HMS-RIC/DattaLab-HumidityChamber/Humidity-Chamber-v1-BOM.xlsx

 |  | Datta Lab Humidity Chamber Controller: Part List
Item | PCB Label | Item | Value | Vendor | Part # | Qty | Price | Total | Notes
1 |  | Sensirion SFC6000D-5slm |  | Digikey | 1649-SFC6000D-5SLM-ND | 8 | $372.00 | $2976.00
2 |  | Sensirion MFM |  | Digikey | 1649-SFM6000D-5SLM-ND | 4 | $218.00 | $872.00
3 |  | MFC Cables |  | Digikey | WM17189-ND | 12 | $2.50 | $30.00
4 |  | 1/4" Tubing Adptor for MFCs (10 pack) |  | Digikey | 2171-QSPK18-1/4-U-ND | 3 | $24.30 | $72.90 | Helpful if using 1/4" OD Tubing; By default MFCs will work with 6mm OD tubing
5 |  | PCB |  | Advanced Circuits |  | 1 | $33.00 | $33.00 | Minimum order of 3 to qualify for the $33 special
6 | D1 | LED 3mm |  | Digikey | 732-5008-ND | 1 | $0.15 | $0.15 | Optional, Any comparable part is fine
7 | J1–2 | BNC Connector |  | Digikey | WM5514-ND | 2 | $4.69 | $9.38 | Or try A32245-ND
8 | J3–5 | 1x3 Header |  | Digikey | A19430-ND | 3 |  | $0.00
9 | J6 | 1x12 Socket |  | Digikey | S7045-ND | 1 |  | $0.00
10 | J7 | Barrel Jack |  | Digikey | CP-202A-ND | 1 | $0.61 | $0.61
11 | J8 | 4-way RJ-45 Connector |  | Digikey | 151-1120-ND | 1 | $4.12 | $4.12
12 | J9–10, J13–18, J21–24 | Senserion connectors | Molex 5055680681 | Digikey | WM26835CT-ND | 12 | $1.02 | $12.24
13 | J11,J12,J19,J20 | Qwiic connector |  | Digikey | 455-SM04B-SRSS-TBCT-ND | 1 | $0.52 | $0.52 | Or try A32245-ND
14 | R1 | Resistor | 2k |  |  | 1 |  | $0.00
15 | R2,R8 | Resistor | 1.2k |  |  | 2 |  | $0.00
16 | R3,R4,R9,R10 | Resistor | 10k |  |  | 4 |  | $0.00
17 | R5,R7,R11,R13 | Resistor | 560 |  |  | 4 |  | $0.00
18 | R6,R12 | Resistor | 2.7k |  |  | 2 |  | $0.00
19 | SW1 | Switch | 500SSP1S1M6QEA | Digikey | EG2478-ND | 1 | $3.92 | $3.92 | Optional; Be sure to cut solder jumper (JP1) if using switch
20 | U1 | Teensy 4.1 with Headers |  | Sparkfun | DEV-16997 | 1 | $26.80 | $26.80
21 |  | 1x24 Socket |  | Digikey | S7057-ND | 2 | $1.35 | $2.70
22 |  | Power Supply 24V DC 2A |  | Digikey | 364-1286-ND | 1 | $19.38 | $19.38
23 |  | Standoffs |  | McMaster | 92745A320 | 4 | $0.63 | $2.52
 |  |  |  |  |  |  | TOTAL | $4066.24
