HMS-RIC/DattaLab-HumidityChamber/Humidity Chamber PCB - KiCAD/plots/Datta Lab Humidity Chamber PCB__Assembly.pdf

MountingHole H5 Teensy4.1 | GPIO-1 C3-1 C3-2 Cam2-1 Cam2-2 TX-1 RX-1 | GPIO-5 GPIO-3 GPIO-2 Cam1-2 Cam1-1 TX-2 RX-2 | TX-5 RX-5 | Rig 1 Rig 2 Rig 3 Rig 4
BNC-1 P29 | SDA-1 Teensy 4.1 | MFC⁻¹ | MFM⁻¹ MFC⁻⁵

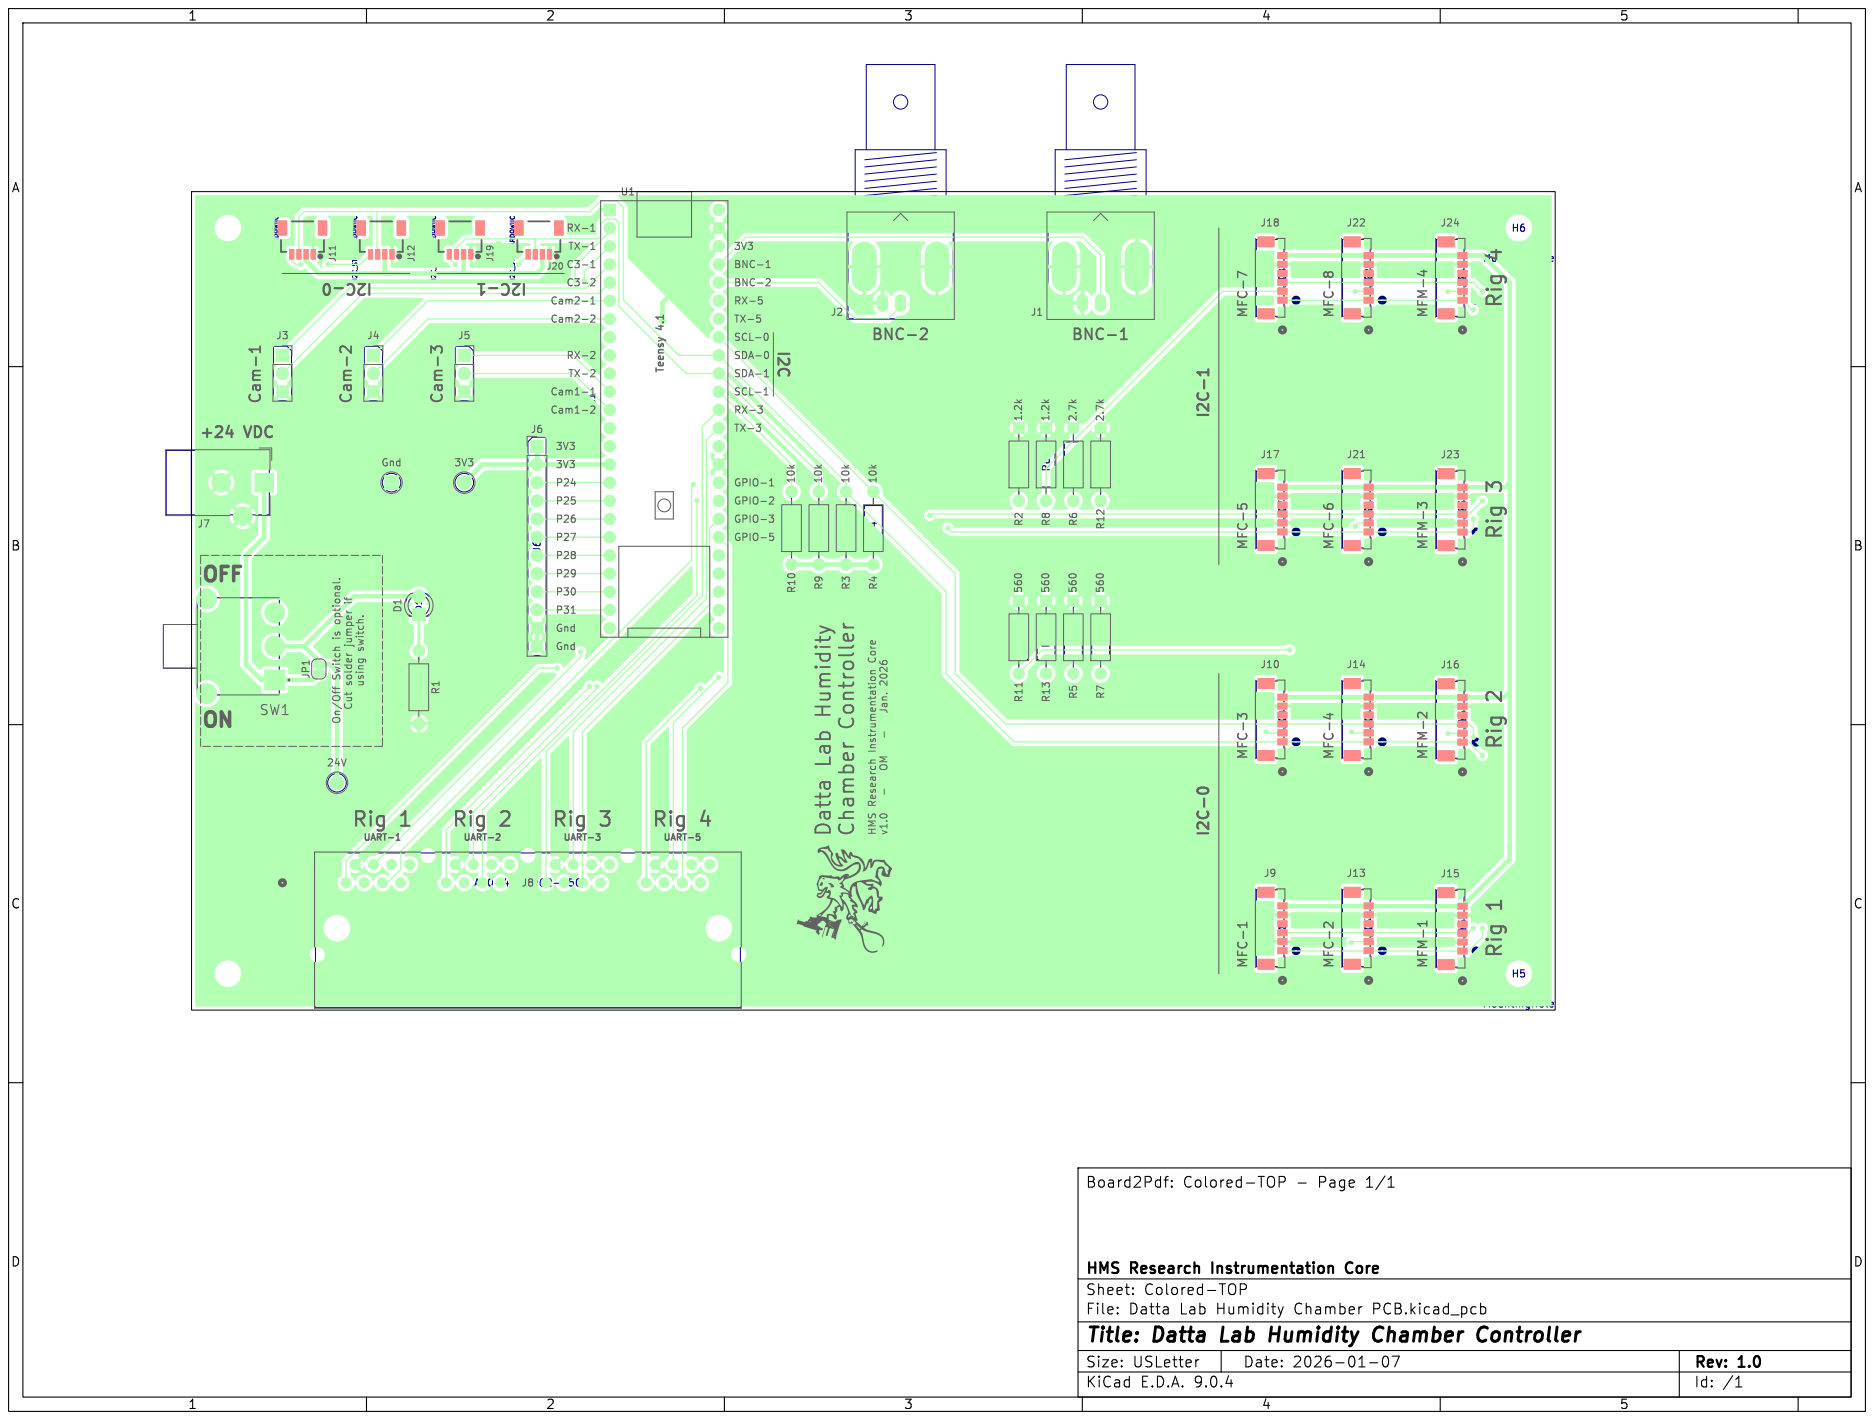
[picture p1: page 1]

R5 R7 R3 R12 R10 R4 R6 R11 R13 R2 R8 MFM 2 J16 MFM 2 J24 MFM 1 J23 MFM 1 J15

TX-3 On/Off Switch is optional. Cut solder jumper if using switch.
