HMS-RIC/DattaLab-HumidityChamber/Humidity Chamber Controller Schematic_v1.0.pdf

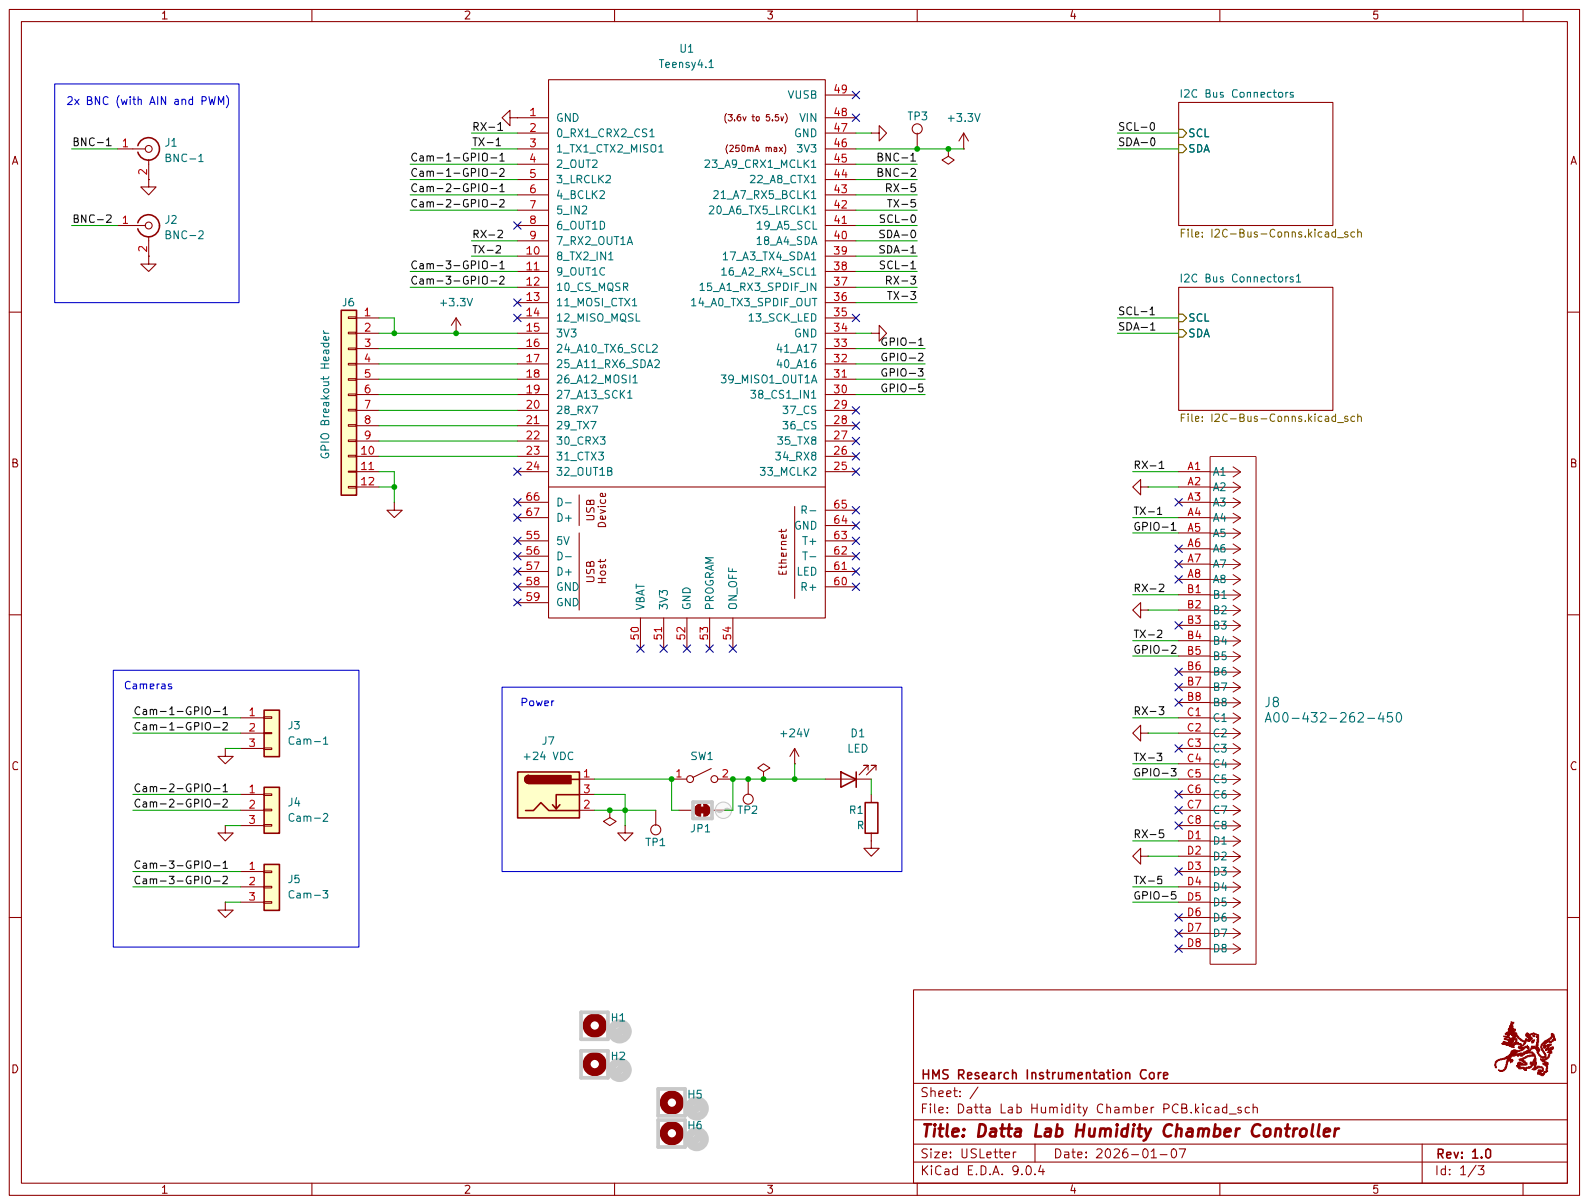
[picture p2: page 1]

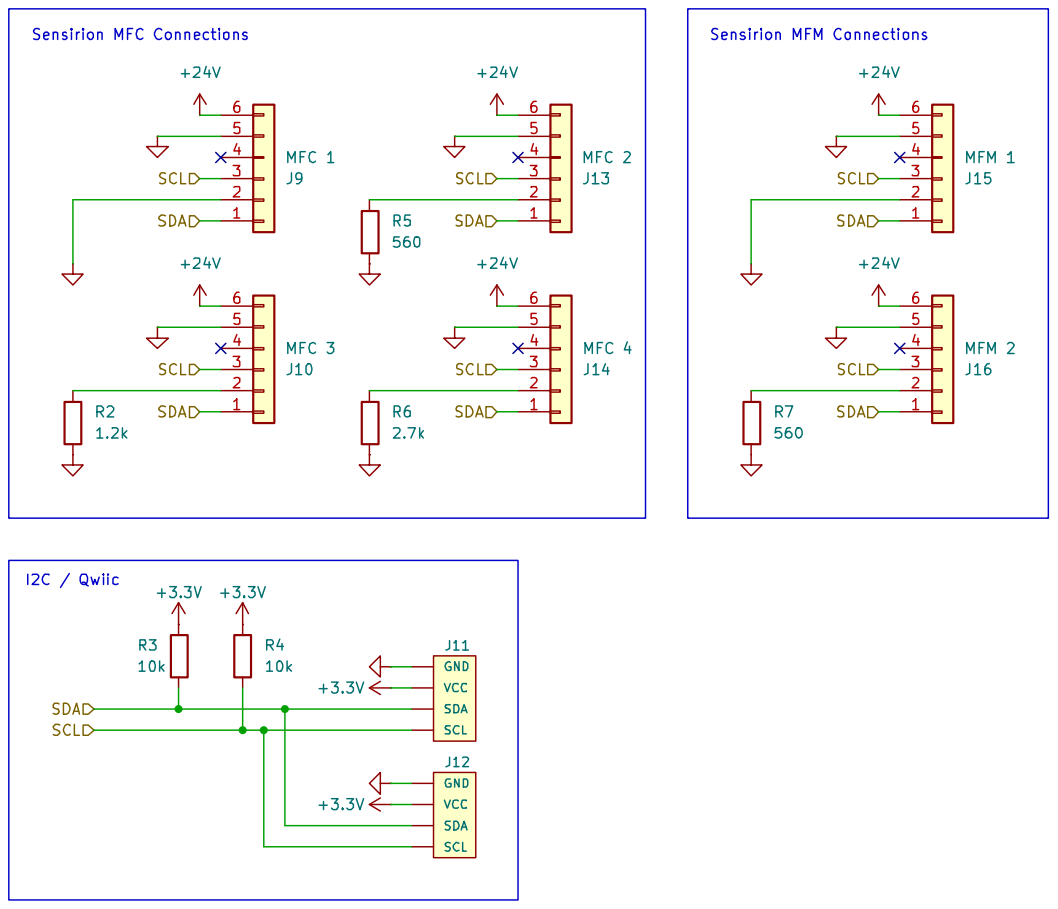
[picture p3: page 2]

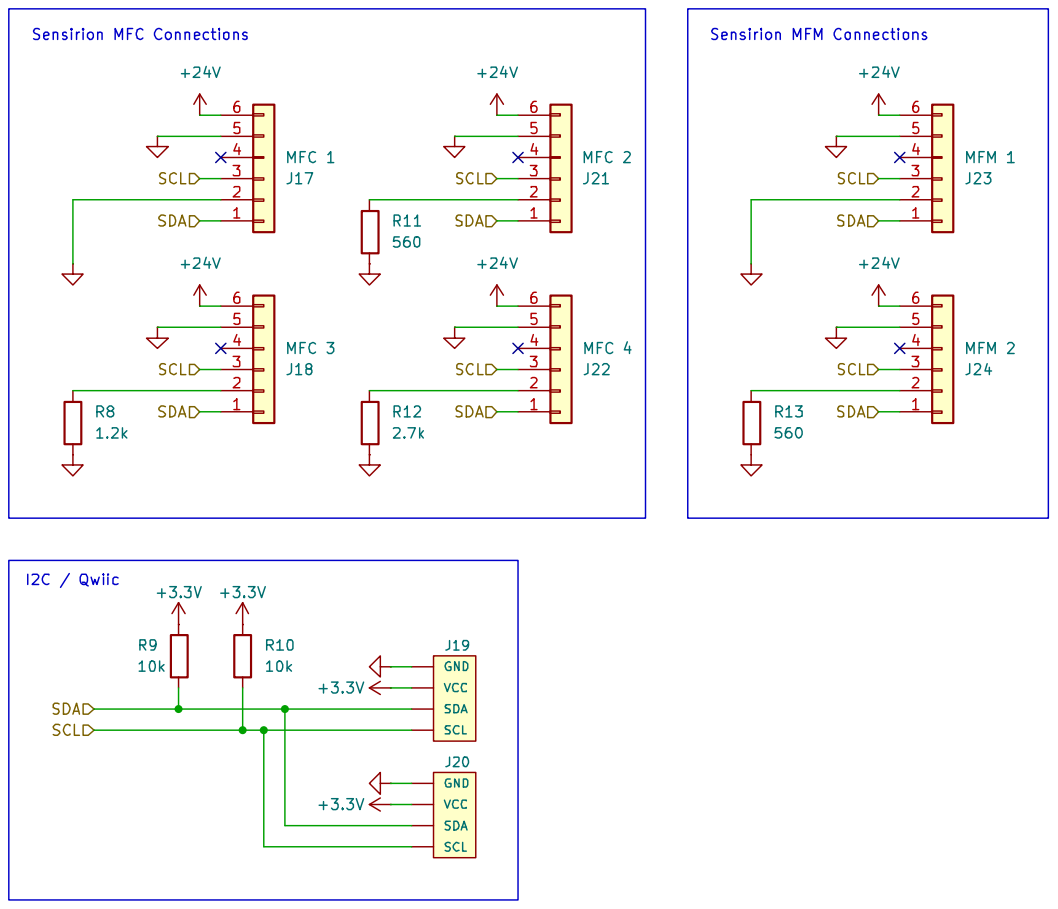
[picture p4: page 3]
