HMS-RIC/DattaLab-HumidityChamber/Humidity Chamber PCB - KiCAD/Datta Lab Humidity Chamber PCB.kicad_pcb

## KiCad design Humidity Chamber PCB - KiCAD/Datta Lab Humidity Chamber PCB.kicad_pcb (2026-01-27)

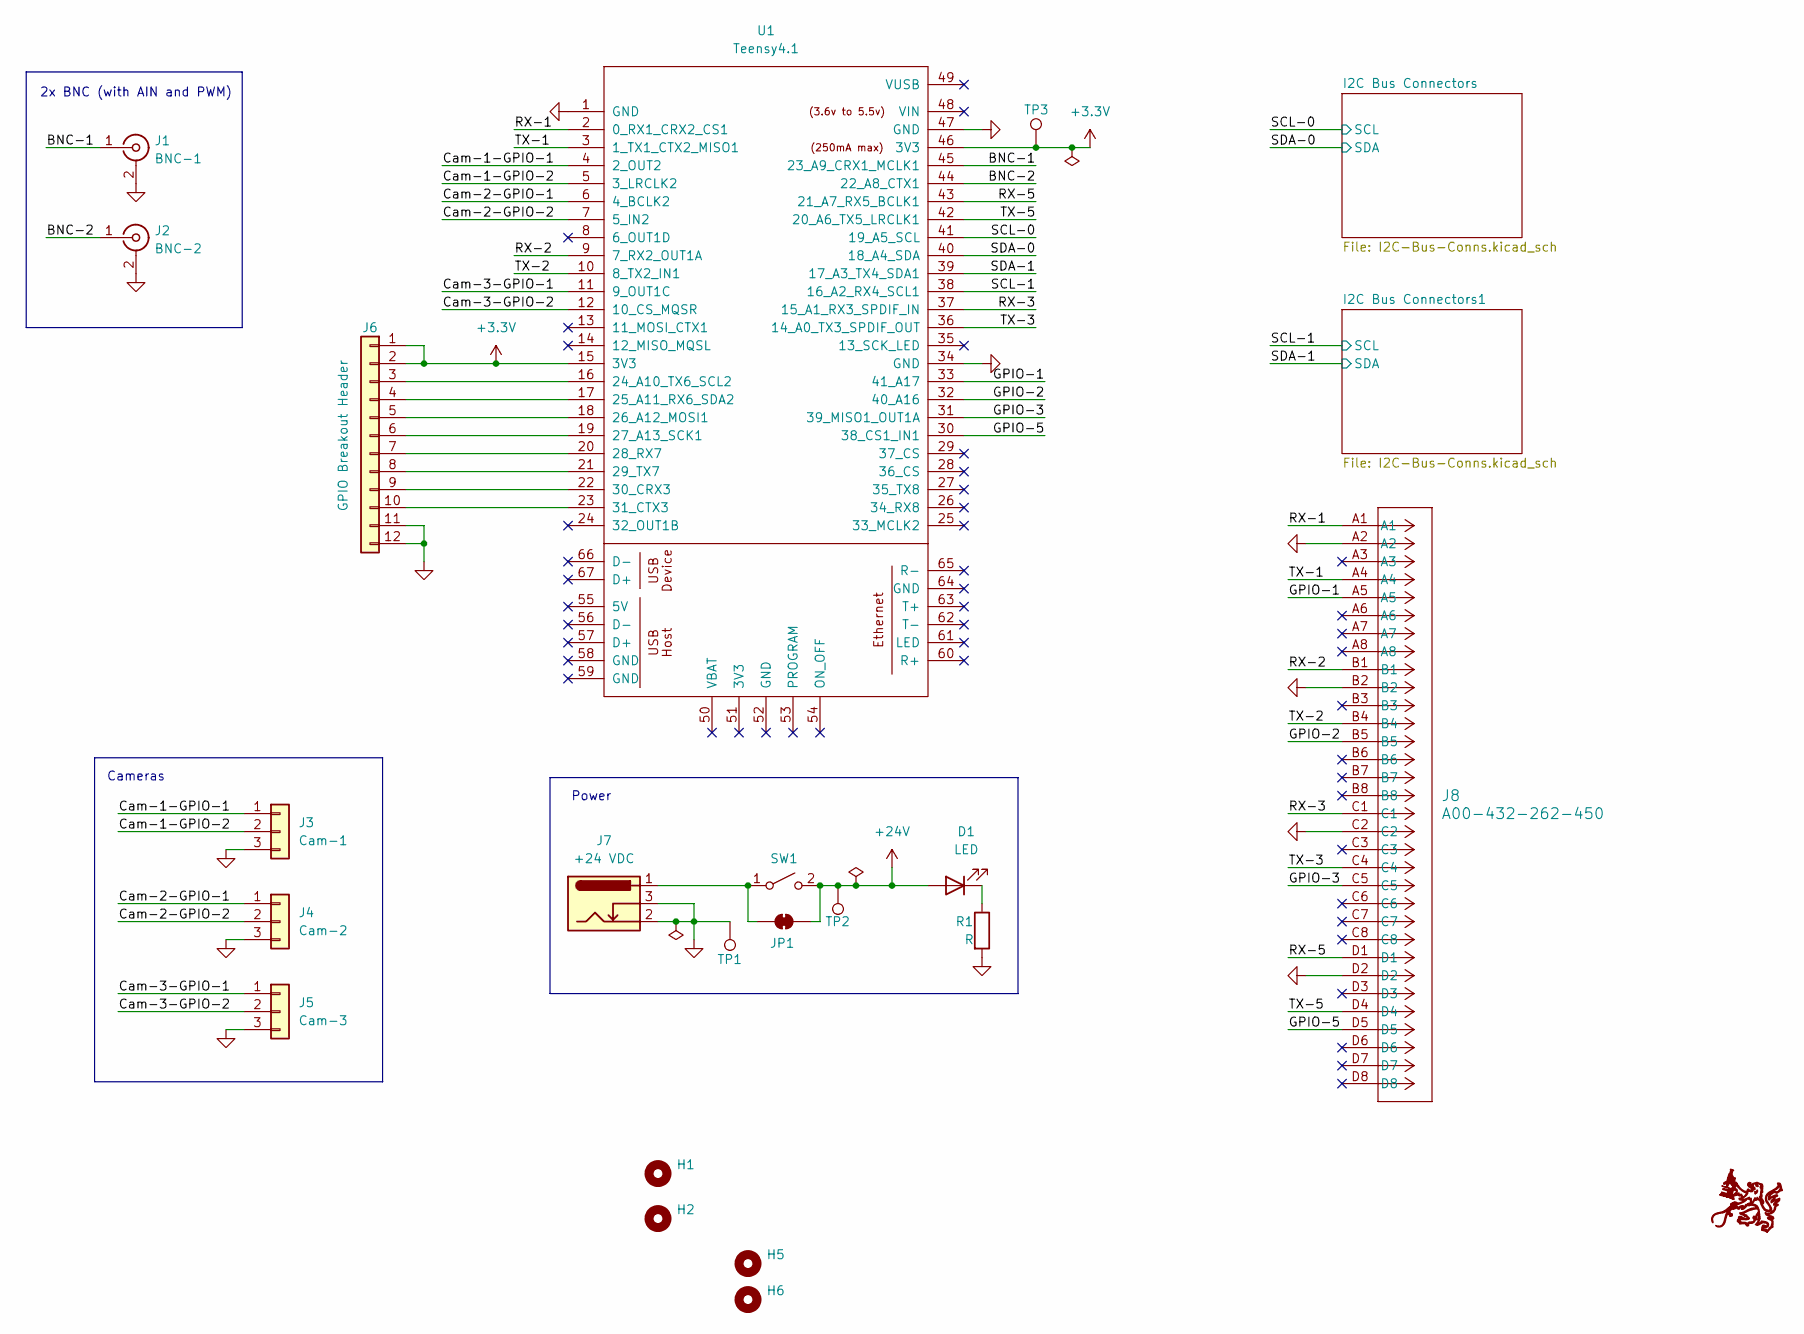
[picture p5: schematic Datta Lab Humidity Chamber PCB.kicad_sch, Datta Lab Humidity Chamber Controller]

Parts:
D1: LED; LED_D3.0mm
G1: RIC_Logo; RIC_Logo_15mm
H1, H2, H5, H6: MountingHole; MountingHole_3.2mm_M3
J1: BNC-1; BNC_Amphenol_B6252HB-NPP3G-50_Horizontal
J2: BNC-2; BNC_Amphenol_B6252HB-NPP3G-50_Horizontal
J3: Cam-1; PinSocket_1x03_P2.54mm_Vertical
J4: Cam-2; PinSocket_1x03_P2.54mm_Vertical
J5: Cam-3; PinSocket_1x03_P2.54mm_Vertical
J6: GPIO Breakout Header; PinHeader_1x12_P2.54mm_Vertical
J7: +24 VDC; BarrelJack_CUI_PJ-102AH_Horizontal
J8: A00-432-262-450; CONN_A00-432-262-450_EDA
JP1: SolderJumper_2_Open; SolderJumper-2_P1.3mm_Bridged_RoundedPad1.0x1.5mm
R1: R; R_Axial_DIN0207_L6.3mm_D2.5mm_P10.16mm_Horizontal
SW1: 500SSP1S1M6QEA; SW_500SSP1S1M6QEA
TP1: Gnd; TestPoint_Loop_D1.80mm_Drill1.0mm_Beaded
TP2: 24V; TestPoint_Loop_D1.80mm_Drill1.0mm_Beaded
TP3: 3V3; TestPoint_Loop_D1.80mm_Drill1.0mm_Beaded
U1: Teensy4.1; Teensy41_noInternalPins

Connections:
+3.3V: J6.1, J6.2, TP3.1, U1.15 (3V3), U1.46 (3V3); also elsewhere on the board
+24V: D1.2 (A), JP1.2 (B), SW1.2 (B), TP2.1; also elsewhere on the board
/BNC-1: J1.1 (In), U1.45 (23_A9_CRX1_MCLK1)
/BNC-2: J2.1 (In), U1.44 (22_A8_CTX1)
/Cam-1-GPIO-1: J3.1, U1.4 (2_OUT2)
/Cam-1-GPIO-2: J3.2, U1.5 (3_LRCLK2)
/Cam-2-GPIO-1: J4.1, U1.6 (4_BCLK2)
/Cam-2-GPIO-2: J4.2, U1.7 (5_IN2)
/Cam-3-GPIO-1: J5.1, U1.11 (9_OUT1C)
/Cam-3-GPIO-2: J5.2, U1.12 (10_CS_MQSR)
/GPIO-1: J8.A5, U1.33 (41_A17)
/GPIO-2: J8.B5, U1.32 (40_A16)
/GPIO-3: J8.C5, U1.31 (39_MISO1_OUT1A)
/GPIO-5: J8.D5, U1.30 (38_CS1_IN1)
/RX-1: J8.A1, U1.2 (0_RX1_CRX2_CS1)
/RX-2: J8.B1, U1.9 (7_RX2_OUT1A)
/RX-3: J8.C1, U1.37 (15_A1_RX3_SPDIF_IN)
/RX-5: J8.D1, U1.43 (21_A7_RX5_BCLK1)
/SCL-0: U1.41 (19_A5_SCL); also elsewhere on the board
/SCL-1: U1.38 (16_A2_RX4_SCL1); also elsewhere on the board
/SDA-0: U1.40 (18_A4_SDA); also elsewhere on the board
/SDA-1: U1.39 (17_A3_TX4_SDA1); also elsewhere on the board
/TX-1: J8.A4, U1.3 (1_TX1_CTX2_MISO1)
/TX-2: J8.B4, U1.10 (8_TX2_IN1)
/TX-3: J8.C4, U1.36 (14_A0_TX3_SPDIF_OUT)
/TX-5: J8.D4, U1.42 (20_A6_TX5_LRCLK1)
GND: J1.2 (Ext), J2.2 (Ext), J3.3, J4.3, J5.3, J6.11, J6.12, J7.2, J7.3, J8.A2, J8.B2, J8.C2, J8.D2, R1.2, TP1.1, U1.1 (GND), U1.34 (GND), U1.47 (GND); also elsewhere on the board
unnamed: D1.1 (K), R1.1
unnamed: J6.3, U1.16 (24_A10_TX6_SCL2)
unnamed: J6.4, U1.17 (25_A11_RX6_SDA2)
unnamed: J6.5, U1.18 (26_A12_MOSI1)
unnamed: J6.6, U1.19 (27_A13_SCK1)
unnamed: J6.7, U1.20 (28_RX7)
unnamed: J6.8, U1.21 (29_TX7)
unnamed: J6.9, U1.22 (30_CRX3)
unnamed: J6.10, U1.23 (31_CTX3)
unnamed: J7.1, JP1.1 (A), SW1.1 (A)

Notes on the sheet:
Power
Cameras
2x BNC (with AIN and PWM)

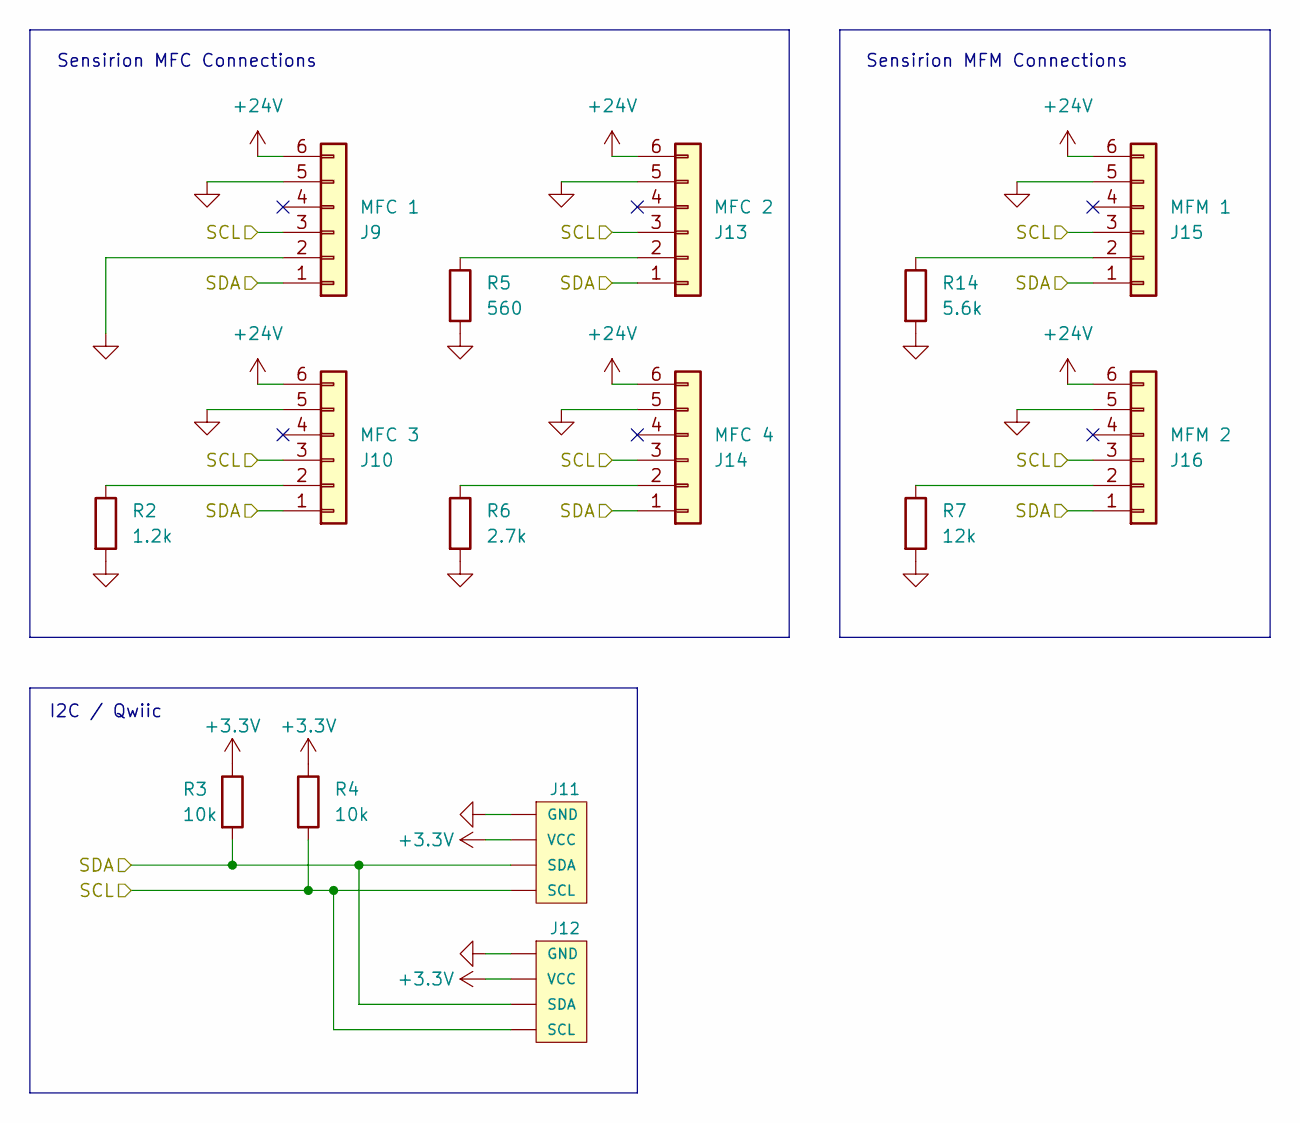
[picture p6: schematic I2C-Bus-Conns.kicad_sch, Datta Lab Humidity Chamber Controller]

Parts:
J9: MFC 1; CONN_50556806xx_MOL
J10: MFC 3; CONN_50556806xx_MOL
J11, J12: I2C_STANDARDQWIIC; 1X04_1MM_RA
J13: MFC 2; CONN_50556806xx_MOL
J14: MFC 4; CONN_50556806xx_MOL
J15: MFM 1; CONN_50556806xx_MOL
J16: MFM 2; CONN_50556806xx_MOL
R2: 1.2k; R_Axial_DIN0207_L6.3mm_D2.5mm_P10.16mm_Horizontal
R3, R4: 10k; R_Axial_DIN0207_L6.3mm_D2.5mm_P10.16mm_Horizontal
R5: 560; R_Axial_DIN0207_L6.3mm_D2.5mm_P10.16mm_Horizontal
R6: 2.7k; R_Axial_DIN0207_L6.3mm_D2.5mm_P10.16mm_Horizontal
R7: 12k; R_Axial_DIN0207_L6.3mm_D2.5mm_P10.16mm_Horizontal
R14: 5.6k; R_Axial_DIN0207_L6.3mm_D2.5mm_P10.16mm_Horizontal

Connections:
+3.3V: J11.2 (VCC), J12.2 (VCC), R3.1, R4.1; also elsewhere on the board
+24V: J9.6, J10.6, J13.6, J14.6, J15.6, J16.6; also elsewhere on the board
/SCL-0: J9.3, J10.3, J11.4 (SCL), J12.4 (SCL), J13.3, J14.3, J15.3, J16.3, R4.2; also elsewhere on the board
/SDA-0: J9.1, J10.1, J11.3 (SDA), J12.3 (SDA), J13.1, J14.1, J15.1, J16.1, R3.2; also elsewhere on the board
GND: J9.2, J9.5, J10.5, J11.1 (GND), J12.1 (GND), J13.5, J14.5, J15.5, J16.5, R2.2, R5.2, R6.2, R7.2, R14.2; also elsewhere on the board
unnamed: J10.2, R2.1
unnamed: J13.2, R5.1
unnamed: J14.2, R6.1
unnamed: J15.2, R14.1
unnamed: J16.2, R7.1

Parts of its further copies:
J17: MFC 1; CONN_50556806xx_MOL
J18: MFC 3; CONN_50556806xx_MOL
J19, J20: I2C_STANDARDQWIIC; 1X04_1MM_RA
J21: MFC 2; CONN_50556806xx_MOL
J22: MFC 4; CONN_50556806xx_MOL
J23: MFM 1; CONN_50556806xx_MOL
J24: MFM 2; CONN_50556806xx_MOL
R8: 1.2k; R_Axial_DIN0207_L6.3mm_D2.5mm_P10.16mm_Horizontal
R9, R10: 10k; R_Axial_DIN0207_L6.3mm_D2.5mm_P10.16mm_Horizontal
R11: 560; R_Axial_DIN0207_L6.3mm_D2.5mm_P10.16mm_Horizontal
R12: 2.7k; R_Axial_DIN0207_L6.3mm_D2.5mm_P10.16mm_Horizontal
R13: 12k; R_Axial_DIN0207_L6.3mm_D2.5mm_P10.16mm_Horizontal
R15: 5.6k; R_Axial_DIN0207_L6.3mm_D2.5mm_P10.16mm_Horizontal

Connections of its further copies:
+3.3V: J19.2 (VCC), J20.2 (VCC), R9.1, R10.1; also elsewhere on the board
+24V: J17.6, J18.6, J21.6, J22.6, J23.6, J24.6; also elsewhere on the board
/SCL-1: J17.3, J18.3, J19.4 (SCL), J20.4 (SCL), J21.3, J22.3, J23.3, J24.3, R10.2; also elsewhere on the board
/SDA-1: J17.1, J18.1, J19.3 (SDA), J20.3 (SDA), J21.1, J22.1, J23.1, J24.1, R9.2; also elsewhere on the board
GND: J17.2, J17.5, J18.5, J19.1 (GND), J20.1 (GND), J21.5, J22.5, J23.5, J24.5, R8.2, R11.2, R12.2, R13.2, R15.2; also elsewhere on the board
unnamed: J18.2, R8.1
unnamed: J21.2, R11.1
unnamed: J22.2, R12.1
unnamed: J23.2, R15.1
unnamed: J24.2, R13.1

Notes on the sheet:
Sensirion MFC Connections
I2C / Qwiic
Sensirion MFM Connections

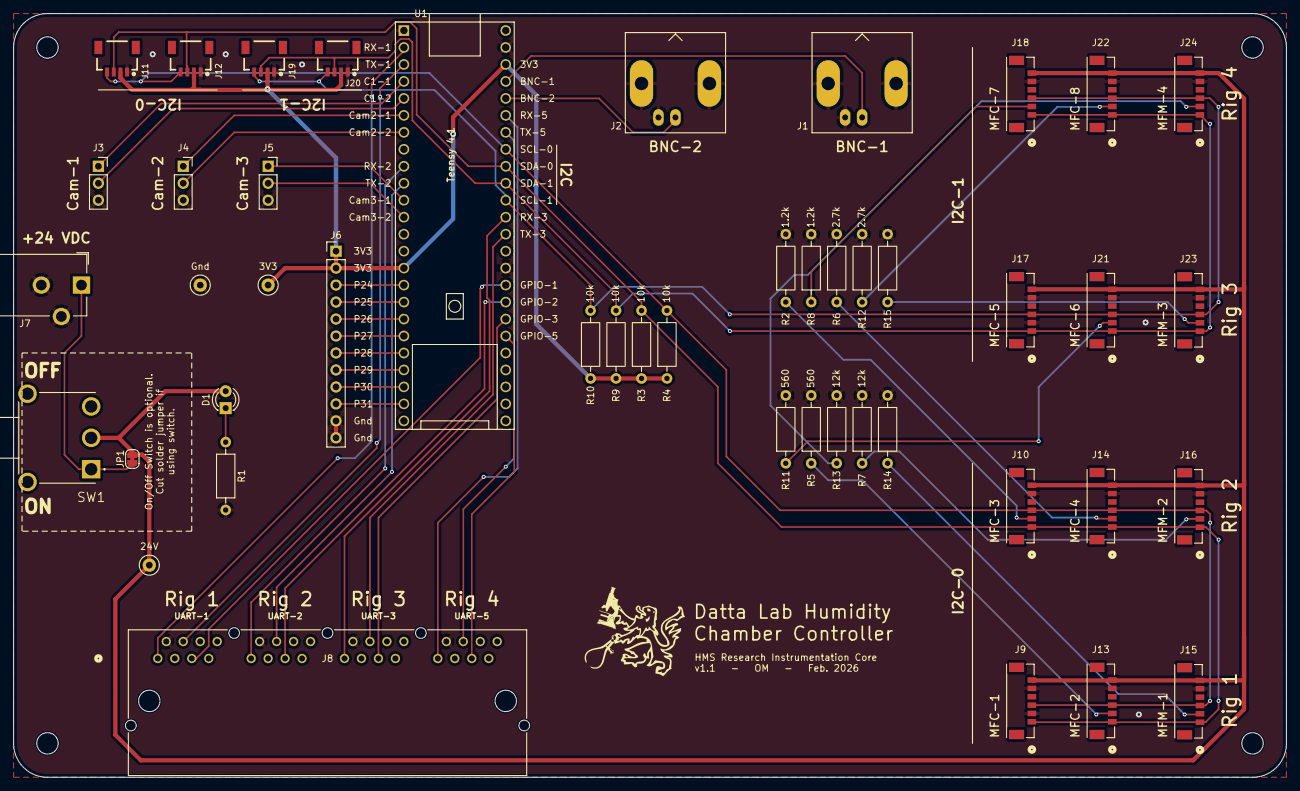
[picture p7: board Datta Lab Humidity Chamber PCB.kicad_pcb from above]

Board: 2 copper layers, 190.5 x 114.3 mm, 51 parts (0 on the bottom side), 47 nets.
