HMS-RIC/DattaLab-HumidityChamber/(commit log)

2026-01-07 Restructure directories
    [Datta Lab Humidity Chamber PCB.kicad_pcb, Datta Lab Humidity Chamber PCB.kicad_sch, Humidity-Chamber-v1-BOM.xlsx, I2C-Bus-Conns.kicad_sch]
2026-01-14 Rearrange board layout per Brian's feedback
    [Datta Lab Humidity Chamber PCB.kicad_pcb]
2026-01-14 Routed all traces
    [Datta Lab Humidity Chamber PCB.kicad_pcb, Datta Lab Humidity Chamber PCB.kicad_sch]
2026-01-14 Minor cosmetic adjustments
    [Datta Lab Humidity Chamber PCB.kicad_pcb, Datta Lab Humidity Chamber PCB.kicad_sch]
2026-01-14 Rounded PCB corners; More minor fixes
    [Datta Lab Humidity Chamber PCB.kicad_pcb]
2026-01-14 Simplified 24V traces
    [Datta Lab Humidity Chamber PCB.kicad_pcb]
2026-01-14 Generate Gerbers; A few small tweaks
    [Datta Lab Humidity Chamber PCB-B_Cu.gbr, Datta Lab Humidity Chamber PCB-B_Mask.gbr, Datta Lab Humidity Chamber PCB-B_Paste.gbr, Datta Lab Humidity Chamber PCB-B_Silkscreen.gbr, Datta Lab Humidity Chamber PCB-Edge_Cuts.gbr, Datta Lab Humidity Chamber PCB-F_Cu.gbr, Datta Lab Humidity Chamber PCB-F_Mask.gbr, Datta Lab Humidity Chamber PCB-F_Paste.gbr]
2026-01-14 Update BOM
    [Humidity-Chamber-v1-BOM.xlsx]
2026-01-27 Start v1.1. Fix address resistors for MFMs
    [Datta Lab Humidity Chamber PCB.kicad_pcb, Datta Lab Humidity Chamber PCB.kicad_sch, I2C-Bus-Conns.kicad_sch]
